salor02/iot-project-smart-gym/environment-sensors-node/main/main.c

#include <stdio.h>
#include "freertos/FreeRTOS.h"
#include "freertos/task.h"
#include "driver/gpio.h"
#include "driver/uart.h"
#include "esp_event.h"
#include "esp_netif.h"
#include "esp_timer.h"
#include "esp_adc/adc_oneshot.h"
#include "nvs_flash.h"
#include "esp_log.h"
#include "mqtt_client.h"

#include "wifi.h"
#include "mqtt.h"
#include "env_sensors.h"
#include "pir.h"
#include "pms.h"

static const char *TAG = "main";

// this task is called by another task and produces a sound from the buzzer. It deletes itself upon termination
void sound_task(void *pvParameters){
    int cycles = (int) pvParameters;

    gpio_reset_pin(CONFIG_BUZZER_GPIO);
    gpio_set_direction(CONFIG_BUZZER_GPIO, GPIO_MODE_OUTPUT);

    for(int i = 0; i < cycles; i++){
        gpio_set_level(CONFIG_BUZZER_GPIO, 1);
        vTaskDelay(pdMS_TO_TICKS(200));
        gpio_set_level(CONFIG_BUZZER_GPIO, 0);
        vTaskDelay(pdMS_TO_TICKS(200));
    }

    vTaskDelete(NULL);
}

// this function waits for a data ready event to be raised and then it display the message through the serial monitor
void serial_logger_handler(void* handler_args, esp_event_base_t base, int32_t id, void* event_data){
    if(base == PIR_EVENT){
        switch(id){
            case EVENT_MOTION_DETECTED: { 
                printf(" ----- HC-SR501 PIR data begin ----- \n");
                printf("Motion detected\n");
                printf(" ----- HC-SR501 PIR data end ----- \n");
                break;
            }

            case EVENT_MOTION_STOPPED: {
                printf(" ----- HC-SR501 PIR data begin ----- \n");
                printf("Motion stopped\n");
                printf(" ----- HC-SR501 PIR data end ----- \n");
                break;
            }

            case EVENT_MOTION_CONFIRMED: { 
                printf(" ----- HC-SR501 PIR data begin ----- \n");
                printf("Motion confirmed\n");
                printf(" ----- HC-SR501 PIR data end ----- \n");
                break;
            }

            case EVENT_MOTION_TIMEOUT: {
                printf(" ----- HC-SR501 PIR data begin ----- \n");
                printf("Motion timeout\n");
                printf(" ----- HC-SR501 PIR data end ----- \n");
                break;
            }
        }
        return;
    }

    if(base == PMS_EVENT){
        switch(id){
            case EVENT_PMS_DATA_READY: {
                pms_data_t *pms_data = (pms_data_t*) event_data;
                printf(" ----- PMS5003 data begin ----- \n");
                printf("pm10: %d ug/m3\n", pms_data->pm10);
                printf("pm2.5: %d ug/m3\n", pms_data->pm2_5);
                printf("pm1.0: %d ug/m3\n", pms_data->pm1_0);
                printf("particles > 0.3um / 0.1L: %d\n", pms_data->particles_03um);
                printf("particles > 0.5um / 0.1L: %d\n", pms_data->particles_05um);
                printf("particles > 1.0um / 0.1L: %d\n", pms_data->particles_10um);
                printf("particles > 2.5um / 0.1L: %d\n", pms_data->particles_25um);
                printf("particles > 5.0um / 0.1L: %d\n", pms_data->particles_50um);
                printf("particles > 10.0um / 0.1L: %d\n", pms_data->particles_100um);
                printf(" ----- PMS5003 data end ----- \n");
                break;
            }
        }
        return;
    }

    if (base == ENV_SENSORS_EVENT){
        switch (id) {
            case EVENT_ENV_DATA_READY: {
                env_data_t *env_data = (env_data_t*) event_data;
                printf(" ----- ENVIRONMENT data begin ----- \n");
                if (env_data->temp_valid) {
                    printf("Temperature: %.2f °C\n", env_data->temp);
                } else {
                    printf("Temperature: not available\n");
                }

                if (env_data->humidity_valid) {
                    printf("Humidity: %.2f %%\n", env_data->humidity);
                } else {
                    printf("Humidity: not available\n");
                }

                if (env_data->mq7_valid) {
                    printf("MQ-7 (CO): %d\n", env_data->mq7_val);
                } else {
                    printf("MQ-7 (CO): not available\n");
                }

                if (env_data->mq135_valid) {
                    printf("MQ-135 (Air): %d\n", env_data->mq135_val);
                } else {
                    printf("MQ-135 (Air): not available\n");
                }

                printf(" ----- ENVIRONMENT data end ----- \n");
                break;
            }
        }
        return;
    }
}

// this function waits for a data ready event to be raised and then it sends the message through MQTT, in a topic based on the event type itself.
void mqtt_sender(void* handler_args, esp_event_base_t base, int32_t id, void* event_data){
    // format the MQTT message based on the received message's type and then publish it
    if(base == PIR_EVENT){
        switch(id){
            case EVENT_MOTION_CONFIRMED: {
                mqtt_manager_publish("sensors/pir", "motion_confirmed");
                break;
            }

            case EVENT_MOTION_TIMEOUT: {
                mqtt_manager_publish("sensors/pir", "motion_timeout");
                break;
            }
        }
        return;
    }

    if(base == PMS_EVENT){
        switch(id){
            case EVENT_PMS_DATA_READY: {
                pms_data_t *pms_data = (pms_data_t*) event_data;
                char json_buffer[128];
        
                snprintf(json_buffer, sizeof(json_buffer), 
                    "{\"pm1_0\": %d, \"pm2_5\": %d, \"pm10\": %d}", 
                    pms_data->pm1_0, pms_data->pm2_5, pms_data->pm10);
                
                mqtt_manager_publish("sensors/air_quality", json_buffer);
                break;
            }
        }
        return;
    }

    if(base == ENV_SENSORS_EVENT){
        switch (id) {
            case EVENT_ENV_DATA_READY: {
                env_data_t *env_data = (env_data_t*) event_data;
                char json_buffer[256];

                snprintf(json_buffer, sizeof(json_buffer),
                    "{\"temp\": %.2f, \"temp_valid\": %s, "
                    "\"humidity\": %.2f, \"humidity_valid\": %s, "
                    "\"co\": %d, \"co_valid\": %s, "
                    "\"air\": %d, \"air_valid\": %s}",
                    env_data->temp, env_data->temp_valid ? "true" : "false",
                    env_data->humidity, env_data->humidity_valid ? "true" : "false",
                    env_data->mq7_val, env_data->mq7_valid ? "true" : "false",
                    env_data->mq135_val, env_data->mq135_valid ? "true" : "false");
                
                mqtt_manager_publish("sensors/environment", json_buffer);
                break;
            }
        }
        return;
    }
}

// this function handles the events raised by the MQTT manager on a received message
static void mqtt_recipient(void* handler_args, esp_event_base_t base, int32_t id, void* event_data) {
    mqtt_msg_t *msg = (mqtt_msg_t *)event_data;
    
    if (strcmp(msg->topic, "vision/status") == 0) {
        if (strcmp(msg->payload, "recording_started") == 0) {
            ESP_LOGI(TAG, "Recording started on vision node");
            xTaskCreate(sound_task, "buzzer_start_sound", configMINIMAL_STACK_SIZE * 3, (void *) 2, 5, NULL);
        }

        if (strcmp(msg->payload, "recording_stopped") == 0){
            ESP_LOGI(TAG, "Recording stopped on vision node");
            xTaskCreate(sound_task, "buzzer_start_sound", configMINIMAL_STACK_SIZE * 3, (void *) 2, 5, NULL);
        }

        if (strcmp(msg->payload, "started") == 0){
            ESP_LOGI(TAG, "Vision node started");
            xTaskCreate(sound_task, "buzzer_start_sound", configMINIMAL_STACK_SIZE * 3, (void *) 5, 5, NULL);
        }
    }
}

// this function manages the deep sleep function in order to turn on/off the vision node
void deep_sleep_handler(void* handler_args, esp_event_base_t base, int32_t id, void* event_data){
    if(base == PIR_EVENT){
        switch(id){
            case EVENT_MOTION_CONFIRMED: {
                gpio_set_level(CONFIG_DEEP_SLEEP_GPIO, 1);
                break;
            }

            case EVENT_MOTION_TIMEOUT: {
                gpio_set_level(CONFIG_DEEP_SLEEP_GPIO, 0);
                break;
            }
        }
        return;
    }
}

void sound_led_handler(void* handler_args, esp_event_base_t base, int32_t id, void* event_data){
    switch(id){
        case EVENT_MOTION_DETECTED: { 
            gpio_set_level(CONFIG_LED_GPIO, 1); 
            break;
        }

        case EVENT_MOTION_STOPPED: {
            gpio_set_level(CONFIG_LED_GPIO, 0); 
            break;
        }

        // case EVENT_MOTION_CONFIRMED: {
        //     break;
        // }

        case EVENT_MOTION_TIMEOUT: {
            xTaskCreate(sound_task, "buzzer_start_sound", configMINIMAL_STACK_SIZE * 3, (void *) 1, 5, NULL);
            break;
        }
    }
    return;
}

void app_main()
{
    /* ***** INITIAL SETUP ***** */

    // NVS Initialization
    esp_err_t ret = nvs_flash_init();
    if (ret == ESP_ERR_NVS_NO_FREE_PAGES || ret == ESP_ERR_NVS_NEW_VERSION_FOUND) {
      ESP_ERROR_CHECK(nvs_flash_erase());
      ret = nvs_flash_init();
    }
    ESP_ERROR_CHECK(ret);

    // Initialize TCP/IP stack
    ESP_ERROR_CHECK(esp_netif_init());

    // Event loop creation
    ESP_ERROR_CHECK(esp_event_loop_create_default());

    // WiFi initialization
    if(wifi_init_sta() == ESP_FAIL){
        ESP_LOGE(TAG, "Connection failed, reboot in 10 seconds");
        vTaskDelay(pdMS_TO_TICKS(10000));
        esp_restart();
    }

    // MQTT initialization
    mqtt_manager_config_t mqtt_config = {
        .broker_uri = CONFIG_MQTT_BROKER_URI,
        .subscribe_topics = {
            "vision/status"
        },
        .num_topics = 1
    };
    mqtt_manager_init(&mqtt_config);

    // events' handlers binding
    ESP_ERROR_CHECK(esp_event_handler_register(ESP_EVENT_ANY_BASE, ESP_EVENT_ANY_ID, serial_logger_handler, NULL));
    ESP_ERROR_CHECK(esp_event_handler_register(ESP_EVENT_ANY_BASE, ESP_EVENT_ANY_ID, mqtt_sender, NULL));
    ESP_ERROR_CHECK(esp_event_handler_register(MQTT_MANAGER_EVENTS, MQTT_EVENT_NEW_MESSAGE, mqtt_recipient, NULL));
    ESP_ERROR_CHECK(esp_event_handler_register(PIR_EVENT, ESP_EVENT_ANY_ID, sound_led_handler, NULL));
    ESP_ERROR_CHECK(esp_event_handler_register(PIR_EVENT, ESP_EVENT_ANY_ID, deep_sleep_handler, NULL));

    // LED initialization
    ESP_ERROR_CHECK(gpio_reset_pin(CONFIG_LED_GPIO));
    ESP_ERROR_CHECK(gpio_set_direction(CONFIG_LED_GPIO, GPIO_MODE_OUTPUT));
    ESP_ERROR_CHECK(gpio_set_level(CONFIG_LED_GPIO, 0));

    // Deep sleep PIN initialization
    ESP_ERROR_CHECK(gpio_reset_pin(CONFIG_DEEP_SLEEP_GPIO));
    ESP_ERROR_CHECK(gpio_set_direction(CONFIG_DEEP_SLEEP_GPIO, GPIO_MODE_OUTPUT));
    ESP_ERROR_CHECK(gpio_set_level(CONFIG_DEEP_SLEEP_GPIO, 0));

    // PIR sensor initialization
    ESP_ERROR_CHECK(pir_init(CONFIG_PIR_GPIO));

    // PMS sensor initialization
    ESP_ERROR_CHECK(pms_init(CONFIG_PMS_UART_PORT, CONFIG_PMS_TX_GPIO, CONFIG_PMS_RX_GPIO, CONFIG_PMS_SET_GPIO));

    // Environmental sensors initialization
    ESP_ERROR_CHECK(temp_sensor_init(CONFIG_SHT3X_ADDR, CONFIG_I2C_MASTER_SDA, CONFIG_I2C_MASTER_SCL));
    ESP_ERROR_CHECK(gas_sensors_init(CONFIG_ADC_UNIT, CONFIG_MQ7_ADC_CHANNEL, CONFIG_MQ135_ADC_CHANNEL));

    /* ***** SETUP COMPLETED ***** */

    /* ***** TASKS DECLARATION ***** */

    xTaskCreate(env_sensors_task, "env_sensors_task", configMINIMAL_STACK_SIZE * 3, NULL, 5, NULL);
    xTaskCreate(pms_task, "pms_task", configMINIMAL_STACK_SIZE * 3, NULL, 5, NULL);
}
