salor02/iot-project-smart-gym/vision-node/components/camera_manager/camera_manager.c

#include "esp_camera.h"
#include "esp_log.h"
#include "driver/gpio.h"
#include "camera_manager.h"

static const char *TAG = "camera";

static camera_config_t camera_config = {
    .pin_pwdn  = CAM_PIN_PWDN,
    .pin_reset = CAM_PIN_RESET,
    .pin_xclk = CAM_PIN_XCLK,
    .pin_sccb_sda = CAM_PIN_SIOD,
    .pin_sccb_scl = CAM_PIN_SIOC,

    .pin_d7 = CAM_PIN_D7,
    .pin_d6 = CAM_PIN_D6,
    .pin_d5 = CAM_PIN_D5,
    .pin_d4 = CAM_PIN_D4,
    .pin_d3 = CAM_PIN_D3,
    .pin_d2 = CAM_PIN_D2,
    .pin_d1 = CAM_PIN_D1,
    .pin_d0 = CAM_PIN_D0,
    .pin_vsync = CAM_PIN_VSYNC,
    .pin_href = CAM_PIN_HREF,
    .pin_pclk = CAM_PIN_PCLK,

    .xclk_freq_hz = 15000000,
    .ledc_timer = LEDC_TIMER_0,
    .ledc_channel = LEDC_CHANNEL_0,

    .pixel_format = PIXFORMAT_JPEG,//YUV422,GRAYSCALE,RGB565,JPEG
    .frame_size = FRAMESIZE_VGA,//QQVGA-UXGA, For ESP32, do not use sizes above QVGA when not JPEG. The performance of the ESP32-S series has improved a lot, but JPEG mode always gives better frame rates.

    .jpeg_quality = 15, //0-63, for OV series camera sensors, lower number means higher quality
    .fb_count = 3, //When jpeg mode is used, if fb_count more than one, the driver will work in continuous mode.
    .grab_mode = CAMERA_GRAB_LATEST//CAMERA_GRAB_LATEST. Sets when buffers should be filled
};

esp_err_t camera_init(){
    ESP_LOGI(TAG, "Initializing camera for board: %s", CAM_BOARD_NAME);

    // Power up the camera only when the board exposes a PWDN pin.
    if (CAM_PIN_PWDN >= 0) {
        gpio_set_direction(CAM_PIN_PWDN, GPIO_MODE_OUTPUT);
        gpio_set_level(CAM_PIN_PWDN, 0);
    }

    //initialize the camera
    esp_err_t err = esp_camera_init(&camera_config);
    if (err != ESP_OK) {
        ESP_LOGE(TAG, "Camera Init Failed");
        return err;
    }

    sensor_t *sensor = esp_camera_sensor_get();
    if (sensor != NULL) {
        sensor->set_vflip(sensor, CAM_SENSOR_VFLIP);
        sensor->set_hmirror(sensor, CAM_SENSOR_HMIRROR);
    }

    return ESP_OK;
}
