salor02/iot-project-smart-gym/environment-sensors-node/main/wifi.c

#include <string.h>
#include "freertos/FreeRTOS.h"
#include "freertos/task.h"
#include "freertos/event_groups.h"
#include "esp_system.h"
#include "esp_wifi.h"
#include "esp_event.h"
#include "esp_log.h"
#include "nvs_flash.h"

#include "lwip/err.h"
#include "lwip/sys.h"

/* FreeRTOS event group to signal when we are connected*/
static EventGroupHandle_t s_wifi_event_group;

/* The event group allows multiple bits for each event, but we only care about two events:
 * - we are connected to the AP with an IP
 * - we failed to connect after the maximum amount of retries */
#define WIFI_CONNECTED_BIT BIT0
#define WIFI_FAIL_BIT      BIT1

static const char *TAG = "wifi station";

static int s_retry_num = 0;

static void event_handler(void* arg, esp_event_base_t event_base,
                                int32_t event_id, void* event_data)
{
    if(event_base == WIFI_EVENT){
        /* This event is raised by esp_wifi_start() if it succeds */
        if(event_id == WIFI_EVENT_STA_START){
            esp_wifi_connect();
            return;
        }

        /* This event can be raised by esp_wifi_connect() if it was not possible to connect to the AP */
        if(event_id == WIFI_EVENT_STA_DISCONNECTED){
            if (s_retry_num < CONFIG_ESP_MAXIMUM_RETRY){
                esp_wifi_connect();
                s_retry_num++;
                ESP_LOGI(TAG, "retry to connect to the AP");
            } 
            else{
                xEventGroupSetBits(s_wifi_event_group, WIFI_FAIL_BIT);
            }
            ESP_LOGI(TAG,"connect to the AP fail");
            return;
        }
    }

    /* This event arises when the DHCP client successfully gets the IPV4 address from the DHCP server */
    if (event_base == IP_EVENT && event_id == IP_EVENT_STA_GOT_IP) {
        ip_event_got_ip_t* event = (ip_event_got_ip_t*) event_data;
        ESP_LOGI(TAG, "got ip:" IPSTR, IP2STR(&event->ip_info.ip));
        s_retry_num = 0;
        xEventGroupSetBits(s_wifi_event_group, WIFI_CONNECTED_BIT);
    }
}

esp_err_t wifi_init_sta(void)
{
    // Event group creation, in order to keep track of the wifi init success or failure
    s_wifi_event_group = xEventGroupCreate();

    // WiFi station creation
    esp_netif_create_default_wifi_sta();

    // WiFi driver initialization
    wifi_init_config_t cfg = WIFI_INIT_CONFIG_DEFAULT();
    ESP_ERROR_CHECK(esp_wifi_init(&cfg));

    /*
        The following lines register the event handler for any WIFI event and the GOT_IP event from IP layer
    */
    ESP_ERROR_CHECK(esp_event_handler_instance_register(WIFI_EVENT,
                                                        ESP_EVENT_ANY_ID,
                                                        &event_handler,
                                                        NULL,
                                                        NULL));
    ESP_ERROR_CHECK(esp_event_handler_instance_register(IP_EVENT,
                                                        IP_EVENT_STA_GOT_IP,
                                                        &event_handler,
                                                        NULL,
                                                        NULL));

    // WiFi configuration, based on menuconfig
    wifi_config_t wifi_config = {
        .sta = {
            .ssid = CONFIG_ESP_WIFI_SSID,
            .password = CONFIG_ESP_WIFI_PASSWORD,
            .threshold.authmode = WIFI_AUTH_WPA2_PSK
        },
    };

    ESP_ERROR_CHECK(esp_wifi_set_mode(WIFI_MODE_STA));
    ESP_ERROR_CHECK(esp_wifi_set_config(WIFI_IF_STA, &wifi_config));
    ESP_ERROR_CHECK(esp_wifi_start());

    ESP_LOGI(TAG, "wifi_init_sta finished.");

    /* Waiting until either the connection is established (WIFI_CONNECTED_BIT) or connection failed for the maximum
     * number of re-tries (WIFI_FAIL_BIT). The bits are set by event_handler() */
    EventBits_t bits = xEventGroupWaitBits(s_wifi_event_group,
            WIFI_CONNECTED_BIT | WIFI_FAIL_BIT,
            pdFALSE,
            pdFALSE,
            portMAX_DELAY);

    /* xEventGroupWaitBits() returns the bits before the call returned, hence we can test which event actually
     * happened. */
    if (bits & WIFI_CONNECTED_BIT) {
        ESP_LOGI(TAG, "connected to ap SSID:%s password:%s",
                 CONFIG_ESP_WIFI_SSID, CONFIG_ESP_WIFI_PASSWORD);
        return ESP_OK;
    } else if (bits & WIFI_FAIL_BIT) {
        ESP_LOGE(TAG, "Failed to connect to SSID:%s, password:%s",
                 CONFIG_ESP_WIFI_SSID, CONFIG_ESP_WIFI_PASSWORD);
        return ESP_FAIL;
    } else {
        ESP_LOGE(TAG, "UNEXPECTED EVENT");
        return ESP_FAIL;
    }
}
