salor02/iot-project-smart-gym/(commit log)

2026-01-27 implemented wifi driver
2026-02-22 implemented events handlers for sensor readings
2026-02-25 implemented PIR handler and sw filter
2026-03-01 implemented mqtt sender for pir sensor
2026-03-02 implemented moving avarage filter for sensors readings
2026-03-02 implemented sdcard driver
2026-03-03 implemented wifi exp backoff in case of disconnection
2026-03-07 camera initialization
2026-03-22 implemented current monitor node on esp8266
2026-03-22 calibrated mq7 and mq135
2026-03-23 uploaded nodered flows
2026-04-01 added validity check on environment sensor readings
2026-04-04 improved vision frame rate by reducing clock frequency
